Treydon-York2/light-activated-nightlight-pcb/cad/kicad_assembly_model.step

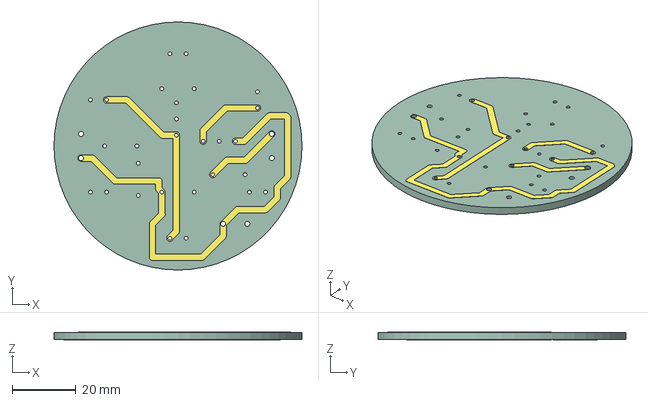
[picture p38: CAD file, 2026-11-03]
cad/kicad_assembly_model.step
78.0 x 78.0 x 2.38 mm
ENGC48E_copper
ENGC48E_PCB
