Treydon-York2/light-activated-nightlight-pcb/fabrication/bottom_copper_traces.dxf

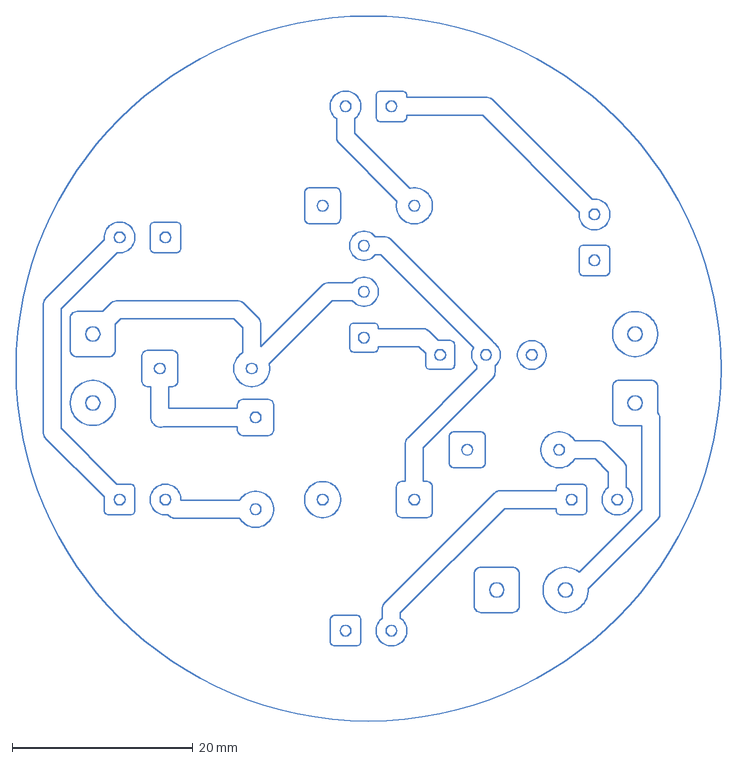
[picture p39: CAD file, 2026-11-03]
fabrication/bottom_copper_traces.dxf
78.0 x 78.0 mm
