Treydon-York2/light-activated-nightlight-pcb/(commit log)

2026-11-03 Add original circuit designs, fabrication files, and project documentation
    [ENGE 098 Final Project.kicad_pcb, ENGE 098 Final Project.kicad_sch, bottom_copper_traces.dxf, kicad_assembly_model.step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]
2026-11-03 Add technical project overview and engineering results
    Updated the README to provide detailed project information, including circuit architecture, electrical analysis, PCB design, testing results, and repository contents.
